OpenAnalog/SevenFortyFun/README.md

SevenFortyFun
=============

SevenFortyFun, a transistor level op amp kit. [ <a href="http://openanalog.brace.io">OPEN ANALOG</a> ]

<b><a href="https://www.kickstarter.com/projects/1208645775/open-analog">KICKSTARTER CAMPAIGN!</a></b>





<b>Most importantly go read about the inventor of the 741 - David Fullagar - at the links below: </b>
  - http://electronicdesign.com/analog/david-fullagar
  - http://www.edn.com/electronics-news/4326905/Voices-Dave-Fullagar-analog-IC-designer-and-entrepreneur

<b>What's in this repo?</b>
  - Gerbers of SevenFortyFun Rev 1.0 <b>UPDATED FILES SEE: https://github.com/acrobotic/OA_SevenFortyFun/tree/master/pcb-main<b>
  - Schematic (SevenFortyFun schematic.png)
  - LTSpice Simulation (SevenFortyFun Simulation.asc)
  - Tutorial/Guide of the SevenFortyFun, an explanantion of each transistors function (SevenFortyFun.pdf)

<b>To run LTSpice simulation download LTSpice (http://www.linear.com/designtools/software/) and then:</b>

  - View SevenFortyFun Simulation.asc
  - Click RAW
  - Copy to notepad (or your favorite text editor)
  - Save as .asc making sure 'save as type:' is selected to 'All Files'
  - Make sure encoding is ANSI
  - Open with LTSpice
  
or just download the whole thing as a zip...

<b>   INSTRUCTIONS FOR INSTALLING COMPONENTS: </b><br>
<b>   _______________________________________ </b>

<b> TRANSISTOR FOOTPRINT </b>
  - Install as silkscreen shape suggests be careful with pnp/npn type 

<b> PINOUT OF HEADERS </b>

  - 1:offset null
  - 2:Inverting Input
  - 3:Non-inverting Input
  - 4:V-
  - 5:offset null
  - 6:Output
  - 7:V+
  - 8:NC

<b>TODO</b>
  - Make datasheet & characterize SevenFortyFun (i.e. slew rate, GBW, etc...)
  - Unify diagrams in the PDF/Make them look <i>pretty</i>
  - Edit out "ideal diode" comment in PDF with the more factual reality of a diode connected transistor - to obtain a very     low leakage diode. For example, a 3904 type transistor will have <1pA of reverse leakage using the Base Emitter     
    junction.

<br>
<br>
<br>

<br />This work is licensed under a <a rel="license" href="http://creativecommons.org/licenses/by-sa/4.0/">Creative Commons Attribution-ShareAlike 4.0 International License</a>.
