OpenAnalog/SevenFortyFun/SevenFortyFun.pdf

SEVENFORTYFUN

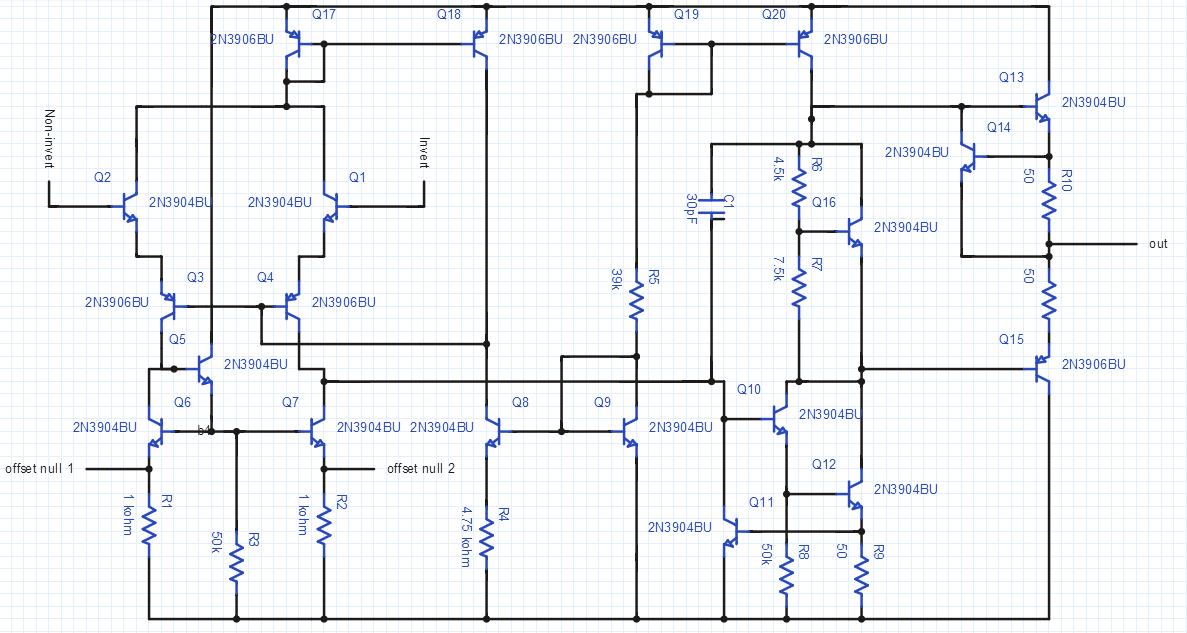
[picture p1: figure]

A smallscale integrated circuit, (http://en.wikipedia.org/wiki/Integrated_circuit) the 741 opamp shares with most opamps an internal structure consisting of three gain stages:

1. Differential amplifier (http://en.wikipedia.org/wiki/Differential_amplifier) — provides high differential amplification (gain), with rejection of commonmode signal, low noise, high input impedance, (http://en.wikipedia.org/wiki/Input_impedance) and drives a
2. Voltage amplifier — provides high voltage gain, a singlepole frequency rolloff, (http://en.wikipedia.org/wiki/Roll-off) and in turn drives the
3. Output amplifier — provides high current gain (low output impedance), (http://en.wikipedia.org/wiki/Output_impedance) along with output current limiting, and output shortcircuit protection.

It’s that easy!

Well, not really.

WARNING: You should understand the basic equations that rule transistors IC = βIB

I | 1 | )I E = ( + β B

## What the Heck is a Differential Amplifier Anyhow?

[Current Mirrors]

Well, before we get into a differential amplifier we must understand the analog building block called a current mirror. A current mirror is a circuit of the configuration in Figure 1. Start with a current Iref which flows into the transistor Q1. A transistor with its collector tied to its base is called a “diode connected transistor” this creates an ideal diode. In turn, this produces a voltage drop across the transistor Q1 of Vbe (about 0.7 volts). Now, since the base and emitter of Q2 is identical and the baseemitter voltage of the transistor Q2 equals the transistor Q1, the same current that flows through Q1, flows through Q2…Well…roughly the
same. As you can see the Im | is a factor of | which works out to be 98% of the current of Q1.
irror

β
β+2

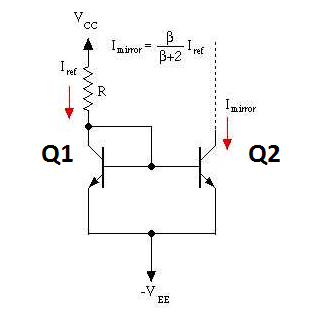
[picture p2: figure]

To derive the Im equation:
irror

Iref = IB + IC

I

ref = IB + 2

βIB

I | I [2 | ]

ref = 2

1
B + β

Therefore,

IB = 2+β

2I
ref

Imirror = 2

βIB

Imirror =

2βIref
2(2+β)
Imirror = β+2

βI
ref

Figure 1

[Differential Amplifiers]

Let me confuse you first and overstate the simplicity of its operation by saying that, simply put, a differential amplifier is a type of amplifier that only amplifies the difference between two voltages and nothing more (idealistically). Besides using different variation of the word amplify and simply way too many times in that last sentence – its operation is a little more complex than I’ve led you to believe thus far…Lets get into the detail.

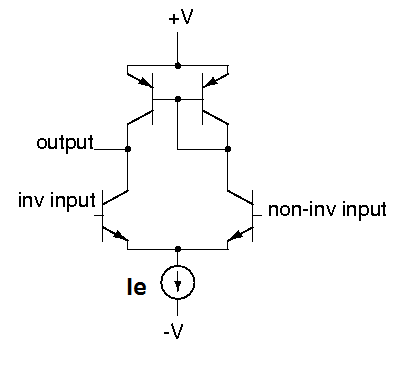
[picture p3: figure]

Figure 2

Long-Tailed Pair.

This is a differential amplifier, often referred to as a longtailed pair. You can see this fundamental analog building block configuration being made between Q17, Q18, Q1 and Q2 of the SEVENFORTYFUN’s schematic. The SEVENFORTYFUN has some additional components involved with its differential pair input, but we will get into that later. Q17 and Q18 make the current mirror of the PNP variety. Check your understanding by working out the math much like we did for the NPN, taking note of the sign differentiation of a PNP, I leave this as an exercise to the reader.

When the voltage at both inputs is equal, then the current Ie is split equally between the two transistors Q1 and Q2. The purpose of Ie is to allocate a set amount of current to the two transistors such that when there is a difference at the inputs we get a differential amplifier. That is, when we increase the voltage at the noninverting input relative to the inverting input Q2 gets more of the current than Q1, and viceversa. I think this will be made more clear after a study of the simulation below.

SEVENFORTYFUN’S SIMULATION

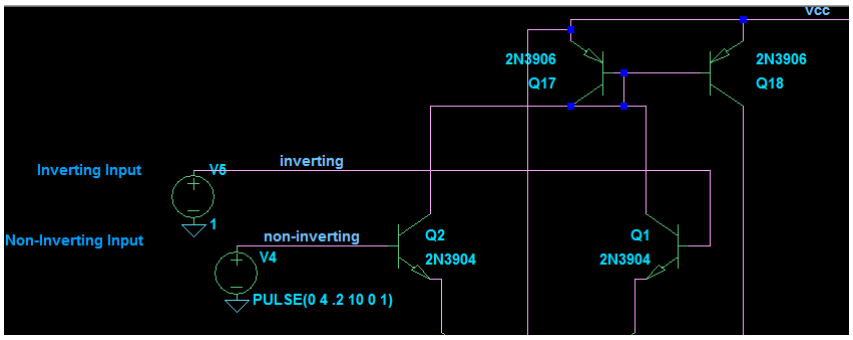
[picture p4: figure]

Figure 3(above), Figure 4(below)

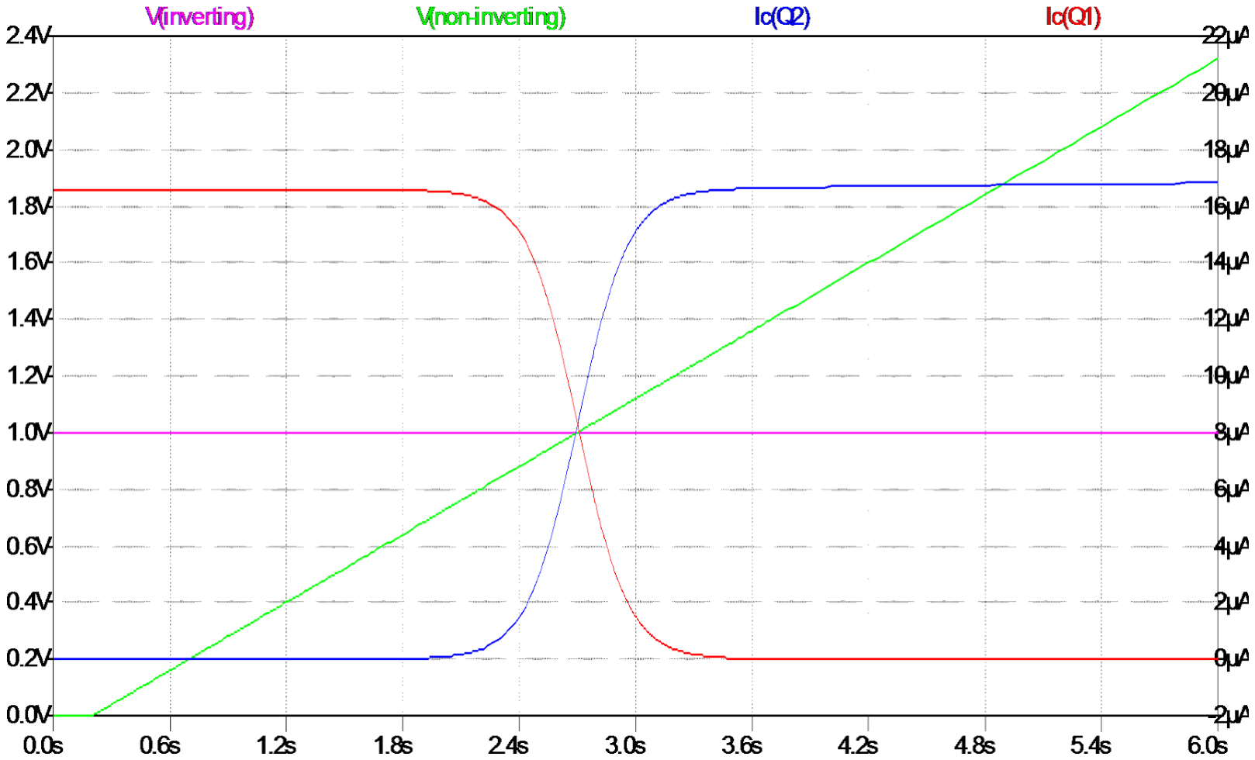
[picture p5: figure]

In the SEVENFORTYFUN the current Ie is produced by the additional circuitry in the input stage. The input stage is made up of Q1, Q2, Q3, Q4, Q5, Q6, and Q7.

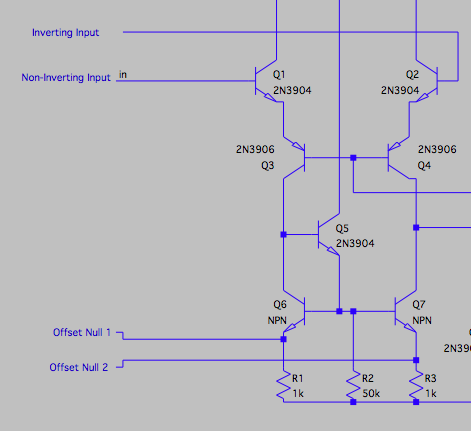
[picture p6: figure]

Q9, Q18 , and R5 are important to the input stage as well because they create the reference current. The the bias for the input stage is created with Q8, Q9 and R4 and current mirror Q17, Q18.

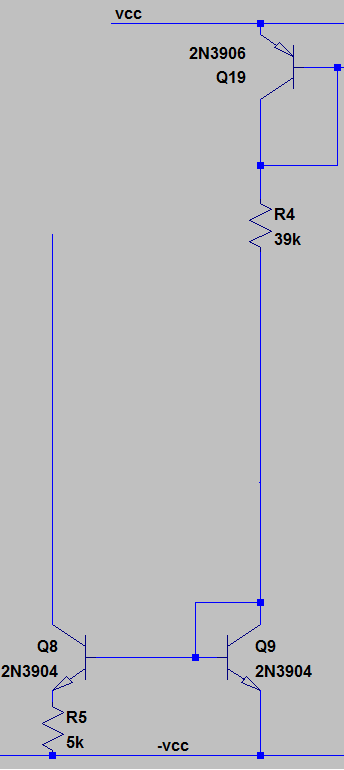
[picture p7: figure]

I can be calculated as follows: ref

I

ref = | R5
V cc−V | −V −(−V ) EB19 | BE9 | EE

Q8, Q9 and R4 create a widlar current source. The first step to understanding a widlar current source is to do some research on the pioneer and analog legend Bob Widlar, an eccentric personality of the analog world, and inventor of the widlar current mirror, among many other things. He, along with many others I will mention, make up the original analog gods. It’s VERY important to read about them.

Anyways, I digress… A Widlar Current source differs from a normal current source because a resistor is added to the emitter of the output stage transistor. In the SevenFortyFun’s schematic this is resistor R4. This is more so a practice in saving IC space when designing the chips. Instead of using large resistors to create small currrents, the Widlar current source creates small currents with small resistors. To calculate the current IC , which is the “output” of the widlar current source follow the KVL around the base emitter 8

loop of this section of the circuit:

V BE9 = V BE8 + IE8R4 = V BE8 + (β + 1)IB8R4

That is,

Where, I ,

IN = IC9

IOUT = IC8
For a BJT, V | ln ( ) so, BE = V T | IS

IC

V T

ln ( ) | ln ( | ) | R IS1

I
IN = V T | IS2

IOUT + IOUT 4

IOU R | ln ( | ) T 4 = V T

I
IN
IOUT

From here you can solve iteratively.

The next important stage is made up by Q3, Q4, Q5, Q6, and Q7. The emitters of the differential input are connected to the emitters of Q3 and Q4, this provides for level shifting, which is required for voltage swing and dc level input at the second stage. The currentmirror load is made up of Q5-Q7 and R1-R3, let’s walk through this a little more.

IC6 = IC7

### I = IC4 = IC3 = IC6 = IC7

IC5 = β

2I + R2

V BE7+IR3 = β
2I + R2

V T

| ln( )+IR I
| IS

3

Hopefully, these equations shed a little more light on the signal path and general functioning of the SEVENFORTYFUN, thus far…I assure you, the input stage is the most complicated part of this circuit.

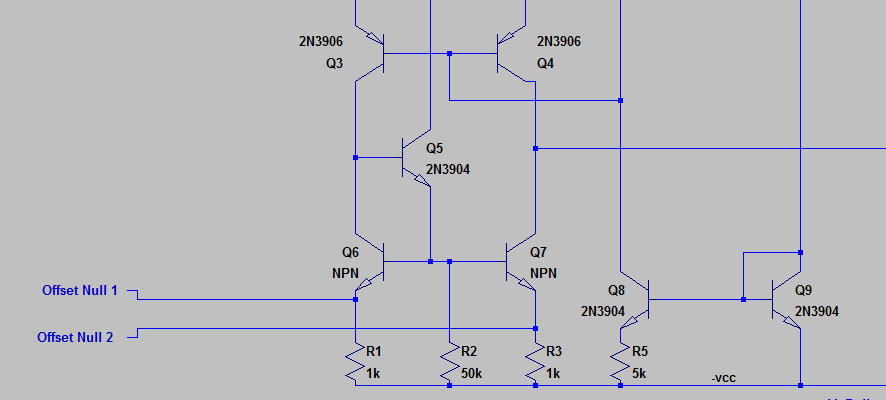
[picture p8: figure]

One more feature you may have noticed is the Offset Null 1 and 2. In simulation this is not necessary to tweak, but in real life it will be necessary to include a pot between Offset Null 1 and 2. Why? Well, when there is no difference between the two inputs (Q1 and Q2) you may get a nonzero output. This is due to transistor and resistor mismatches…Nothings perfect! To balance the mismatches out and obtain a zero output when there is no difference in input you put a pot between offset null 1 and 2 and trim it until your output looks good. To read further on the mathematics about this Texas Instruments has already worked out some good maths about the subject as seen here: http://www.ti.com/lit/an/sloa045/sloa045.pdf

Now this is great and all, we have a pretty solid input stage, things are looking up, we kind of understand what’s going on...But wait! We have a differential input and the SEVENFORTYFUN only has one output. How do we convert the differential input to a single ended signal? Whoa, wait a second, what? Oh don’t worry, the creator of the 741 already thought this out for us. The active load (Q5-Q7, R1-R3) create a modified Wilson current mirror. Its purpose it to take the differential input current and make it a single ended signal without the 50% loss of converting from two signals to one. Follow? It gets a little fuzzy, I know. A small signal differential current in Q3 versus Q4 looks summed at the base of Q10. Study the active load schematic closely…It might take some time to absorb this concept, don’t worry.

Get it? Got it? Good.

Ok now we finally can move on from that input stage. The single ended signal is fed to Q10. Q10 and Q12 create a Darlington configuration. That is, the current amplified by the first transistor Q10 is subsequently amplified again by Q12. This creates a high current gain ( β * β ). Q11 exists as a form of negative feedback

to prevent saturation. If it gets too high, Q11 turns on and diverts the base current going into Q10 to ground, thus stabilizing the configuration. This amplifier uses the output side of the current mirror created between Q19 and Q20, it is an active load. Active loads lead to significant voltage gain because if the active load were perfect the voltage gain would be infinite if you worked out the thevenin equivalent resistance for a current source

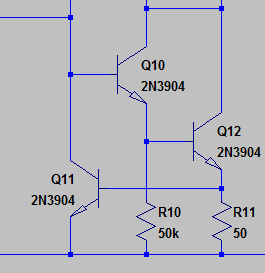
[picture p9: figure]

In figure ?? Q16 provides a voltage level shift. The level shifter stage is included to ensure that there is no dc offset in the output signal. DC offset arises from the turn on voltages of the transistors throughout the circuit. As a exercise run the simulation with and without Q16 noting the differences between the two plots.

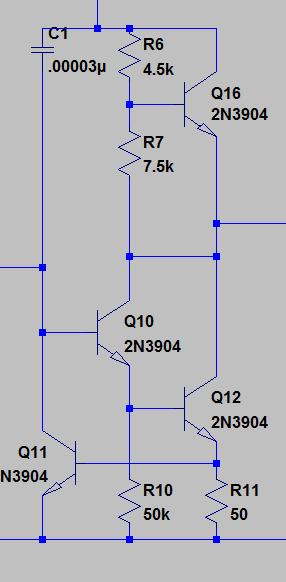
[picture p10: figure]

Finally we arrive at the output stage! The output stage is composed of Q13, Q14 and Q15. The output stage is a Class AB push pull emitter follower amplifier, go look that up if you're not familiar with the concept. Q13 provides output current limiting much like we saw with Q11. That’s it! Go have fun with the PCB and simulation play around with it and I think it will all start coming together.

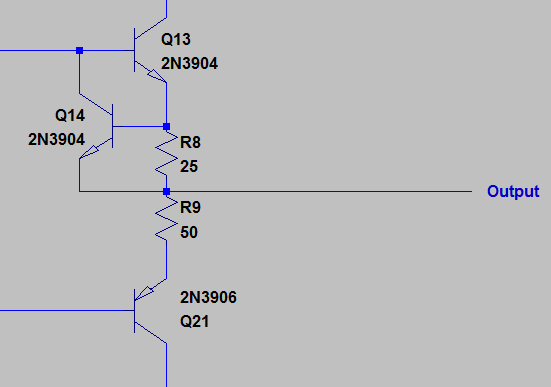
[picture p11: figure]

Some References Used!

http://users.ece.gatech.edu/~alan/ECE3040/Lectures/Lecture31-The%20u741%20Op%20Amp.pdf

http://cc.ee.ntu.edu.tw/~lhlu/eecourses/Electronics2/Electronics_Ch10.pdf

https://coefs.uncc.edu/dlsharer/files/2012/04/G2.pdf
