OpenAnalog/SevenFortyFun/Schematic.png

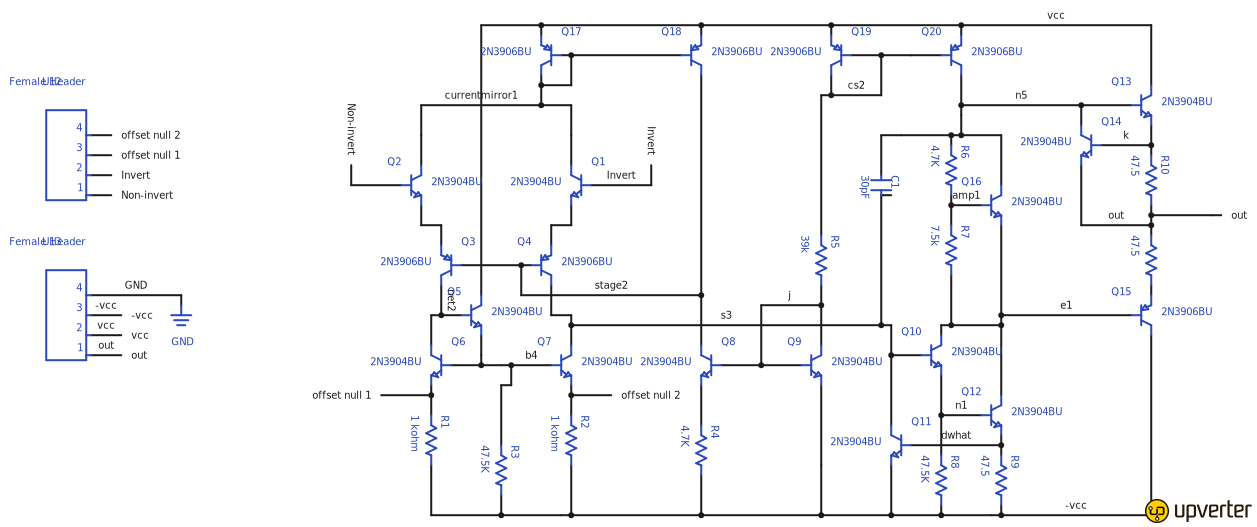
Schematic.png
