OpenAnalog/SevenFortyFun/SevenFortyFun Simulation.asc

C1: cap; .00003µ
Q1: npn; 2N3904
Q2: npn; 2N3904
Q3: pnp; 2N3906
Q4: pnp; 2N3906
Q5: npn; 2N3904
Q6: npn
Q7: npn
Q8: npn; 2N3904
Q9: npn; 2N3904
Q10: npn; 2N3904
Q11: npn; 2N3904
Q12: npn; 2N3904
Q13: npn; 2N3904
Q14: npn; 2N3904
Q15: pnp; 2N3906
Q16: npn; 2N3904
Q17: pnp; 2N3906
Q18: pnp; 2N3906
Q19: pnp; 2N3906
Q20: pnp; 2N3906
R1: res; 1k
R2: res; 50k
R3: res; 1k
R4: res; 39k
R5: res; 5k
R6: res; 4.5k
R7: res; 7.5k
R8: res; 25
R9: res; 50
R10: res; 50k
R11: res; 50
V1: voltage; 12
V2: voltage; -12
V3: voltage; SINE(0 2 5 0 5)
Named nets: 0, vcc, -vcc, in
Inverting Input
Non-Inverting Input
.tran 5
Output
V+ Rail
V- Rail
Offset Null 1
Offset Null 2
