OpenAnalog/SevenFortyFun/(commit log)

2014-05-28 Gerbers first
2014-07-10 Delete SevenFortyFun Schematic.png
    Wrong standard value resistors
2014-07-10 Add Schematic
2014-07-10 Schematic rev
